Hengy/sensornet/Design Docs/SensorNet_root.png

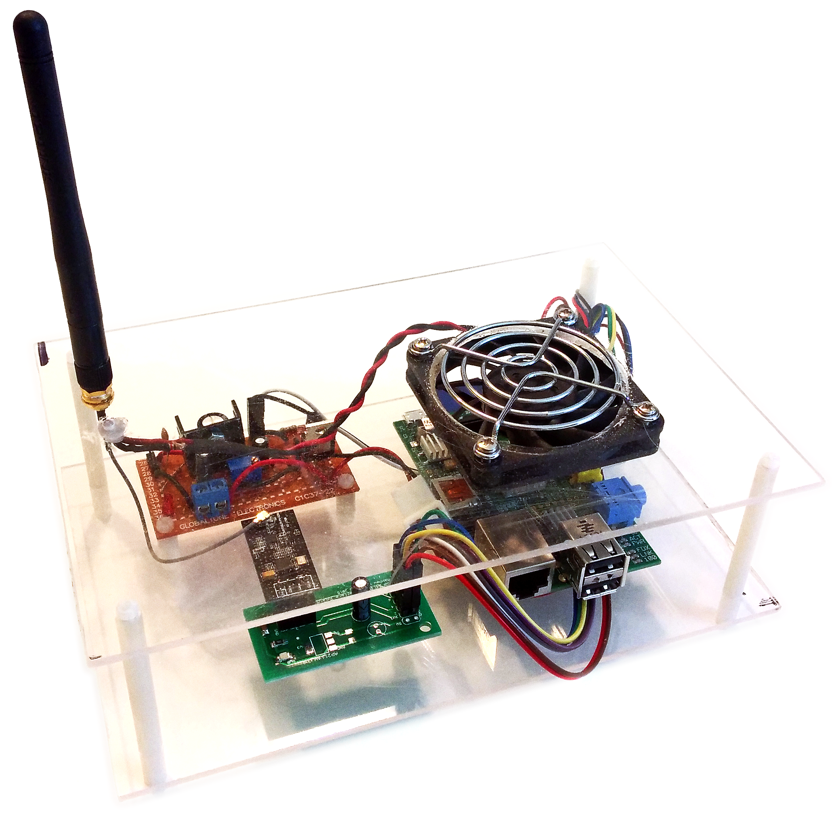
Design Docs/SensorNet_root.png
