Hengy/sensornet/Design Docs/SensorNet_tempSesmor.png

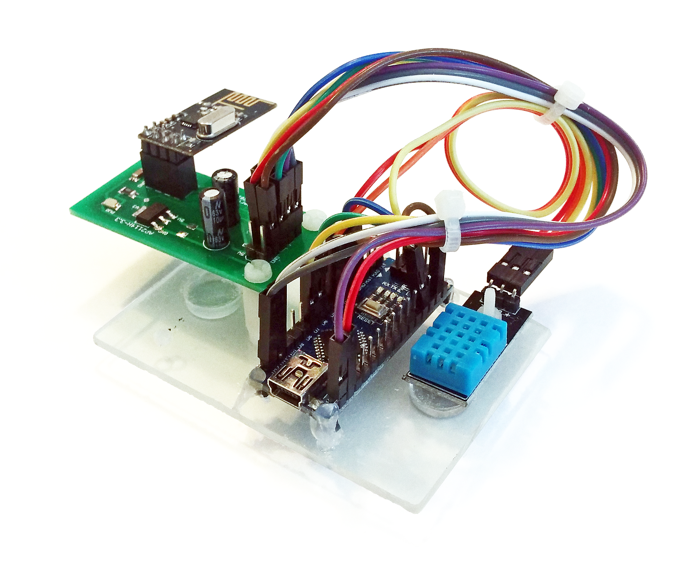
Design Docs/SensorNet_tempSesmor.png
