Hengy/sensornet/nRF24L01+ Libraries/README.md

Libraries
-----------------------------------------------

These are the three libraries for the platforms supported (so far). All require the bcm2835 library found at http://www.airspayce.com/mikem/bcm2835/

This has only been tested to run on the Raspberry Pi model B, and should work on the Raspberry Pi model A, A+, and B+, and these are supported by the bcm2835 library.
