Hengy/sensornet/Design Docs/ArduinoTemp.png

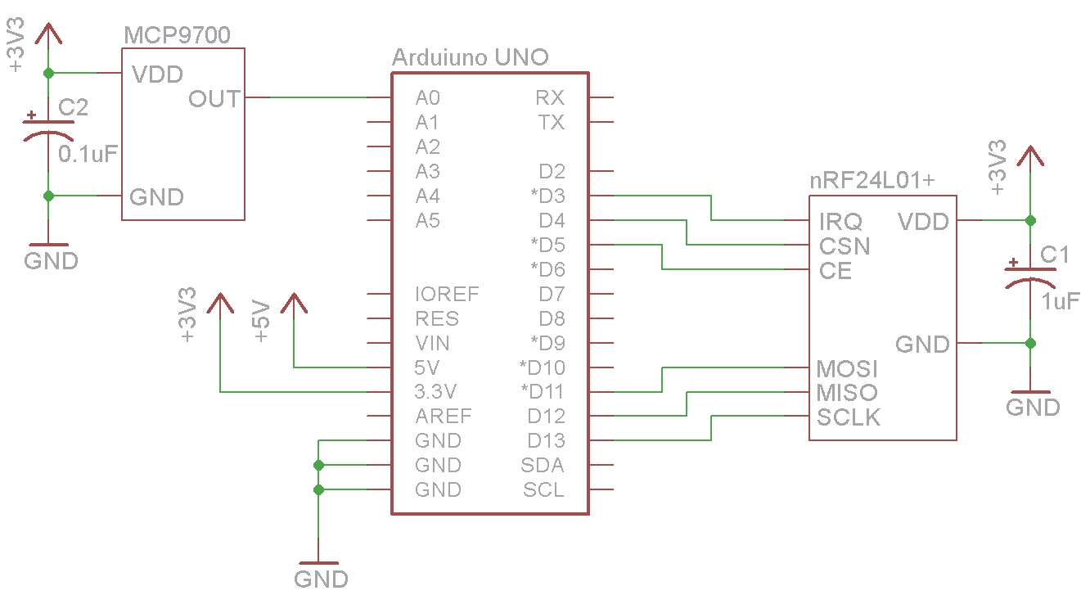
Design Docs/ArduinoTemp.png
