Hengy/sensornet/Design Docs/Crest.png

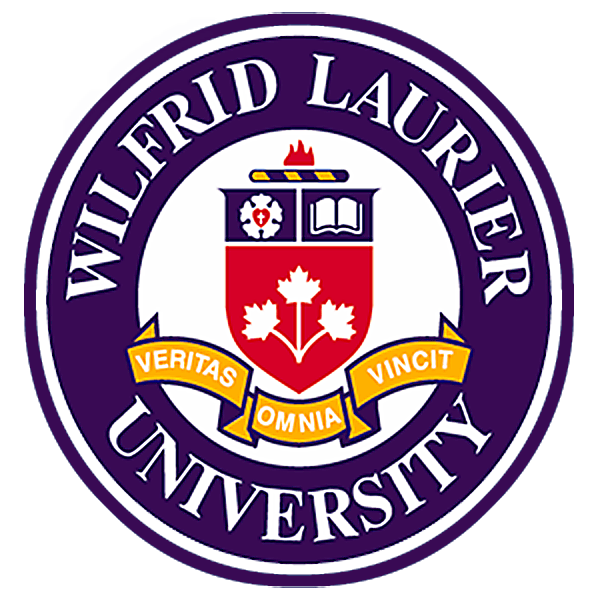
Design Docs/Crest.png
