Hengy/sensornet/Extra/EAGLE/projects/nRF_board.brd

## EAGLE design Extra/EAGLE/projects/nRF_board.brd (2015-01-12)

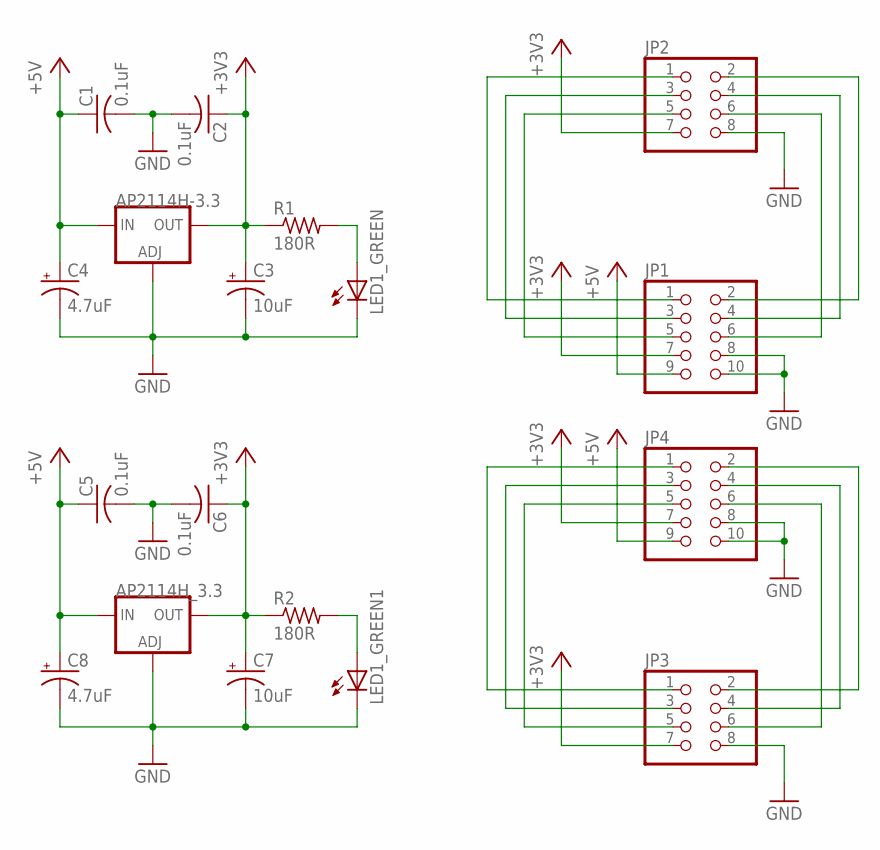
[picture p25: schematic nRF_board.sch]

Parts:
AP2114H-3.3, AP2114H_3.3: LD117AS28TR; SOT223
C1, C2, C5, C6: 0.1uF; C1206K
C3, C7: 10uF; E2-5
C4, C8: 4.7uF; E2-5
JP1, JP4: PINHD-2X5; 2X05
JP2, JP3: PINHD-2X4; 2X04
LED1_GREEN, LED1_GREEN1: LEDSMT1206; 1206
R1, R2: 180R; R1206

Connections:
+3V3: AP2114H-3.3.4 (OUT), AP2114H_3.3.4 (OUT), C2.1, C3.+, C6.1, C7.+, JP1.7, JP2.7, JP3.7, JP4.7, R1.1, R2.1
+5V: AP2114H-3.3.3 (IN), AP2114H_3.3.3 (IN), C1.1, C4.+, C5.1, C8.+, JP1.9, JP4.9
GND: AP2114H-3.3.1 (ADJ), AP2114H_3.3.1 (ADJ), C1.2, C2.2, C3.-, C4.-, C5.2, C6.2, C7.-, C8.-, JP1.8, JP1.10, JP2.8, JP3.8, JP4.8, JP4.10, LED1_GREEN.C, LED1_GREEN1.C
unnamed: LED1_GREEN1.A, R2.2
unnamed: JP1.5, JP2.5
unnamed: LED1_GREEN.A, R1.2
unnamed: JP1.3, JP2.3
unnamed: JP1.1, JP2.1
unnamed: JP1.6, JP2.6
unnamed: JP1.4, JP2.4
unnamed: JP1.2, JP2.2
unnamed: JP3.5, JP4.5
unnamed: JP3.3, JP4.3
unnamed: JP3.1, JP4.1
unnamed: JP3.6, JP4.6
unnamed: JP3.4, JP4.4
unnamed: JP3.2, JP4.2

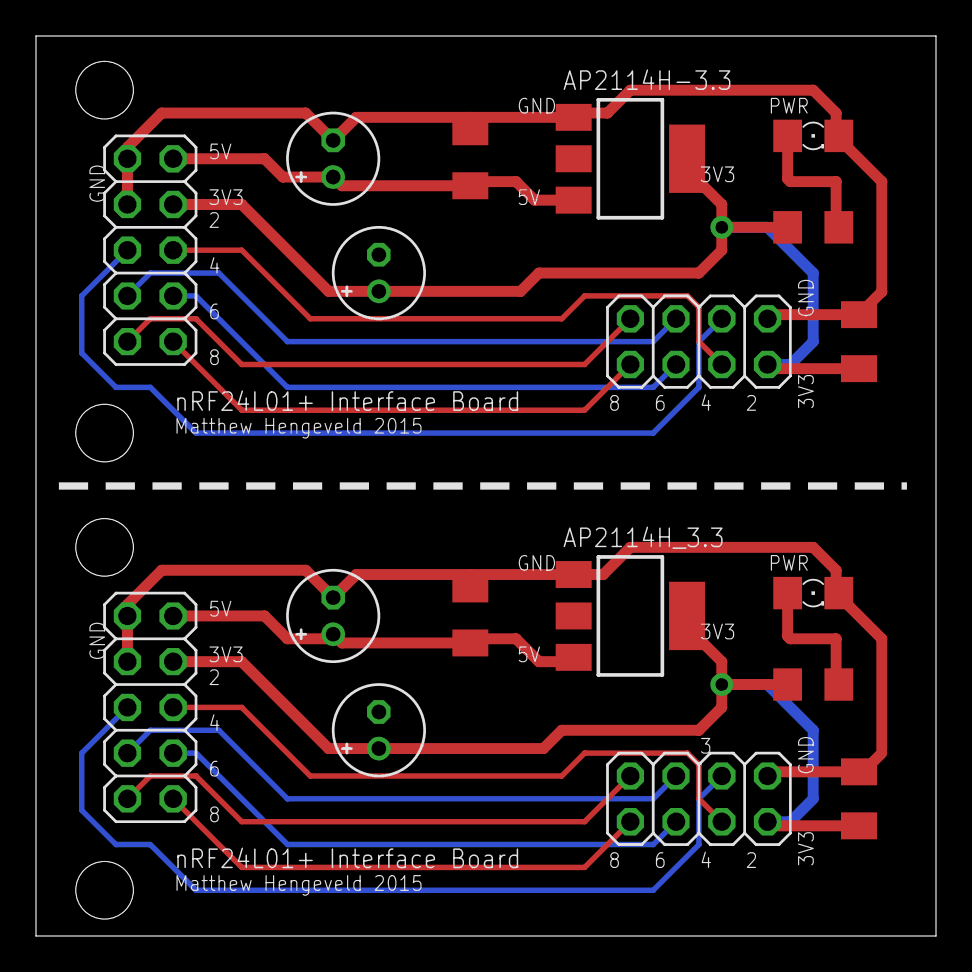
[picture p26: board nRF_board.brd from above]

Board: 2 copper layers, 50.0 x 50.0 mm, 18 parts (0 on the bottom side), 17 nets.
