Hengy/sensornet/(commit log)

2014-09-12 Upload MPLAB X files
    [l.obj, nRF24_TX.X.production.obj]
2014-09-14 Corrs and Mods to files
    Added definition of CSN pin to PIC code
    Corrected CE pin to CSN pin
    Modified Arduino RX code to receive PIC TX
    [main.c]
2014-09-16 Added Arduino Files
2014-09-16 PIC code updated
    [l.obj, nRF24_TX.X.production.obj]
2014-09-17 PIC and Arduino code updated
    [l.obj, nRF24_TX.X.production.obj]
2014-09-18 Arduino SPI, getSTATUS() working
2014-09-19 PIC, Arduino code; MSO Screens
    Arduino SPI is confirmed working. PIC SPI is not confirmed, but scope
    says working. No working wireless communications.
    [l.obj, nRF24_TX.X.production.obj]
2014-09-22 PIC, Arduino code
    wireless not working
    [l.obj, nRF24_TX.X.production.obj]
2014-09-22 PIC, Arduino code
    [l.obj, nRF24_TX.X.production.obj]
2014-09-24 New PIC code
    Rewriting PIC code
    [l.obj, nRF24_TX.X.production.obj]
2014-09-24 PIC code
    TX not working
    [l.obj, nRF24_TX.X.production.obj]
2014-09-24 PIC code - Transmit working!
    PIC transmits, IRQ pin fires, but PIC also spews out a bunch of garbage
    as well. Could be a reset - garbage contains some bytes that look like
    config func...
    [l.obj, nRF24_TX.X.production.obj]
2014-09-25 PIC code - Transmit working, timing
    Working on lowering SPI timing
    [l.obj, nRF24_TX.X.production.obj]
2014-09-25 PIC code - working, timing - 500KHz SPI
    timing is set for SPI speed of 500KHz
    [l.obj, nRF24_TX.X.production.obj]
2014-09-25 Arduino code - WIRELESS WORKS!
    wireless link works - Arduino SPI mode unknown.. (SPI was the problem)
2014-09-25 PIC & Arduino - RX, TX code done
    [l.obj, nRF24_RX.X.production.obj]
2014-09-26 PIC, Arduino code
    PIC - faster SPI (2MHz), RX code
    Arduino - RX Interrupts, TX code
    [l.obj, nRF24_TX.X.production.obj]
2014-09-29 Auto Ack code
    Auto Ack not working
    [l.obj, nRF24_TX.X.production.obj]
2014-09-29 Auto Ack code
    Auto Ack on TX side appears to work; RX side does not send Ack
    [l.obj, nRF24_TX.X.production.obj]
2014-09-29 Arduino INT++ code
2014-09-30 PIC code
    No change
    [l.obj, nRF24_TX.X.production.obj]
2014-09-30 dynamic payload
    problems with interrupts
    [l.obj, nRF24_TX.X.production.obj]
2014-09-30 Revert "PIC & Arduino - RX, TX code done"
    This reverts commit ee72d6f622911c31390f05f9047e60168b804fe3.
    Conflicts:
    Arduino/nRF_RX/nRF_RX.ino
    MPLAB X/nRF24_RX.X/main.c
    MPLAB X/nRF24_RX.X/nbproject/Makefile-genesis.properties
    MPLAB X/nRF_TX/nRF24_TX.X/main.c
    MPLAB X/nRF_TX/nRF24_TX.X/nbproject/Makefile-genesis.properties
    [main.c]
2014-09-30 Revert "PIC, Arduino code"
    This reverts commit 015c358bb45e253f8072ad9c0b4c1d947bb1604c.
    Arduino/nRF_RX_INT/nRF_RX_INT.ino
    MPLAB X/nRF_TX/nRF24_TX.X/build/default/production/main.p1
    MPLAB X/nRF_TX/nRF24_TX.X/build/default/production/main.pre
    MPLAB
    X/nRF_TX/nRF24_TX.X/dist/default/production/nRF24_TX.X.production.cmf
    MPLAB
    X/nRF_TX/nRF24_TX.X/dist/default/production/nRF24_TX.X.production.elf
    MPLAB
    X/nRF_TX/nRF24_TX.X/dist/default/production/nRF24_TX.X.production.hex
    MPLAB
    X/nRF_TX/nRF24_TX.X/dist/default/production/nRF24_TX.X.production.hxl
    MPLAB
    X/nRF_TX/nRF24_T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
    [l.obj]
2014-09-30 Arduino Interrupts;
2014-09-30 PIC, Arduino - Dynamic payload
    dynamic payload working
    [l.obj, nRF24_TX.X.production.obj]
2014-09-30 Dynamic payload - up to 16 bytes
    >15 bytes still sketchy - smaller Arduino loop seems to help to a point
    [l.obj, nRF24_TX.X.production.obj]
2014-10-01 Arduino, PIC - 4MHz SPI
    Dynamic payload working - SPI speed must be > 500KHz to successfully
    transfer > 16 bytes
    [l.obj, nRF24_TX.X.production.obj]
2014-10-01 PIC - starting interrupts
    MSSP1 transfer interrupt
    PORTB interrupt-on-change
    [l.obj, nRF24_TX.X.production.obj]
2014-10-01 PIC interrupts; specify SPI speed
    IRQ changed to RB4; SPI data transmission complete flag instead of
    delay.
    Specify SPI speed using spiConfig argument, _XTAL_FREQ, general formula
    Working on IRQ interrupt using PORTB io change interrupts
    [l.obj, nRF24_TX.X.production.obj]
2014-10-01 PIC all interrupts
    does not work
    [l.obj, nRF24_TX.X.production.obj]
2014-10-02 PIC interrupts
    interrupts working
    [l.obj, nRF24_TX.X.production.obj]
2014-10-02 Starting Auto Ack code
    [l.obj, nRF24_TX.X.production.obj]
2014-10-03 PIC, Arduino - Auto Ack code working
    [l.obj, nRF24_TX.X.production.obj]
2014-10-06 Started Arduino nRFSN library
    [l.obj, nRF24_TX.X.production.obj]
2014-10-06 Arduino nRFSN library
2014-10-09 nRFSN Arduino library
2014-10-09 Arduino nRFSN library
    NOT working
2014-10-14 Arduino nRFSN library - working
2014-10-15 Arduino nRFSN Library
    working; added nRFSNCommands header file
2014-10-15 Arduino nRFSN Library & Template
    Library working, finished; template - no sync()
2014-10-15 Arduino Template
2014-10-16 PIC nRFSN Library
    [l.obj, nRF24_TX.X.production.obj]
2014-10-17 Library stuff
    [l.obj, nRF24_TX.X.production.obj]
2014-10-17 Arduino, PIC libraries
    PIC: C "library" - must reference nRFSN project, took out initial init
    pin settings and SPI speed, added setSPIFreq function
    Arduino: C++ library
    TO DO: mod Arduino library - init(), add setSPIFreq?
2014-11-07 RPi nRFSN library
    RPi -> Arduino works (for first transmission only)
2014-11-14 RPi nRFSN library - MAX_RT interrupt tripping
2014-11-18 RPi nRFSN library WORKS!!
    no MAX_RT interrupt. Fix was pipe 1 not having proper address.
2015-01-12 Arduino Lib Complete
2015-03-12 CH340 driver
2015-03-12 Arduino Nano Pinout
2015-03-26 Arduino nRFSN Lib
2015-03-31 Cleanup
    Cleaned out all old code, files
    [nRF_board.GBL, nRF_board.GBO, nRF_board.GBP, nRF_board.GBS, nRF_board.GTL, nRF_board.GTO, nRF_board.GTP, nRF_board.GTS]
2015-04-15 nRF board and schematic
2015-04-16 Final Report, schematics and photos
